CasuallyAlive/Fuschia_Navigator/Resources/CS5780 receipts.png

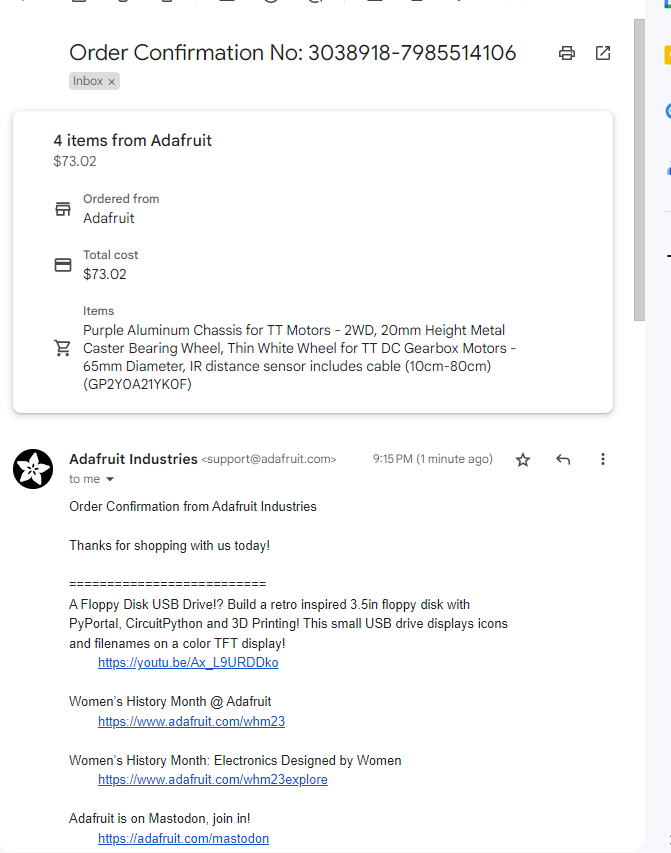
Resources/CS5780 receipts.png
