CasuallyAlive/Fuschia_Navigator/Resources/IMG_9270.jpg

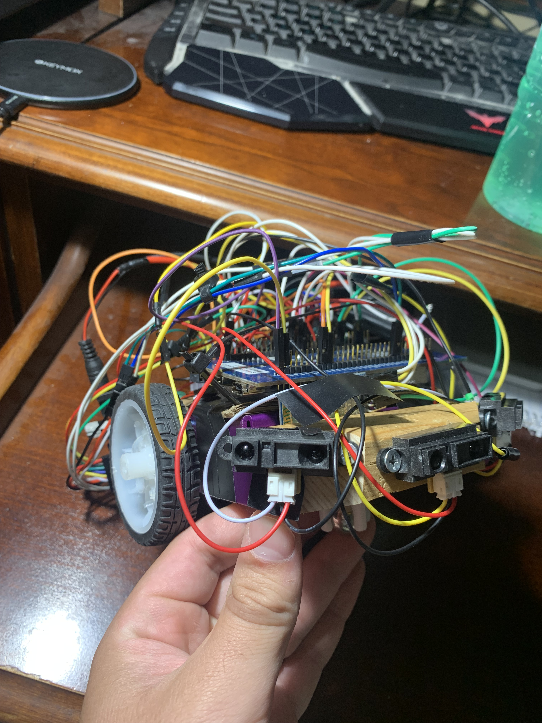
Resources/IMG_9270.jpg
