CasuallyAlive/Fuschia_Navigator/Resources/IMG_9274.jpg

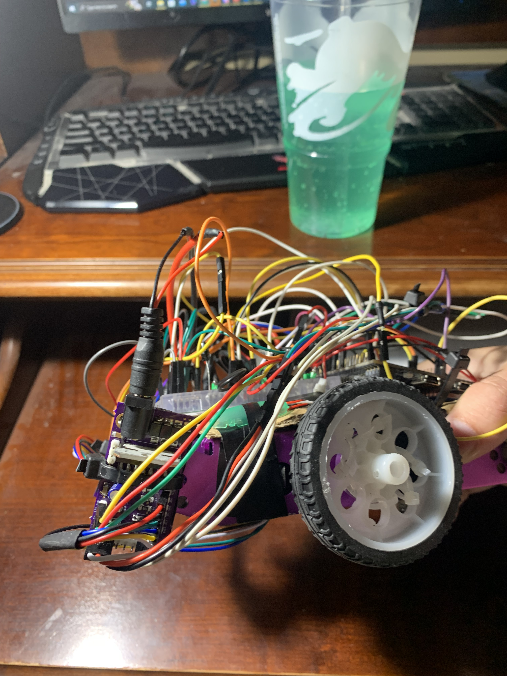
Resources/IMG_9274.jpg
