CasuallyAlive/Fuschia_Navigator/Resources/IMG_9275.jpg

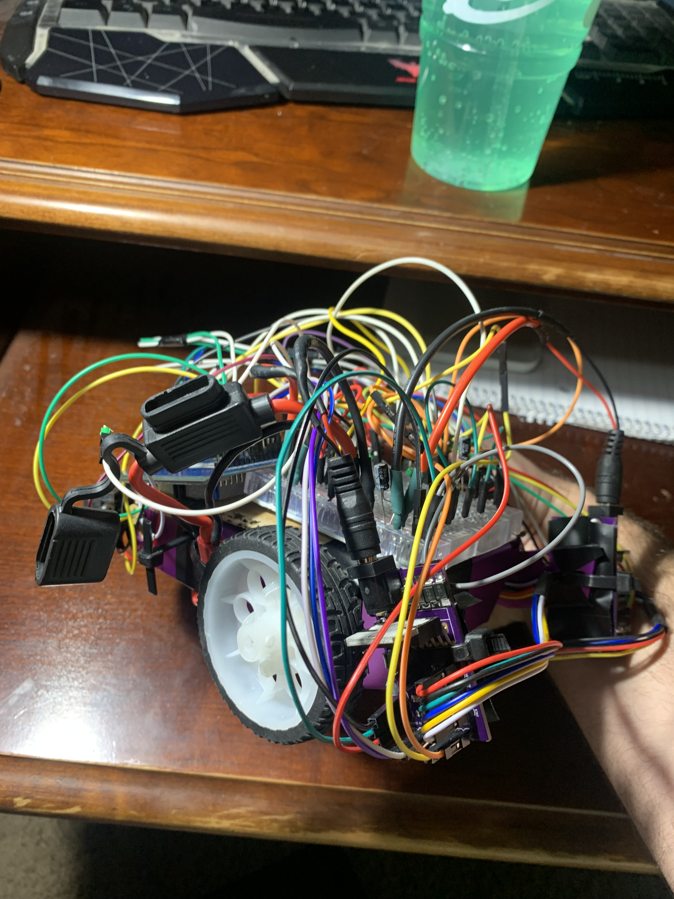
Resources/IMG_9275.jpg
