CasuallyAlive/Fuschia_Navigator/(commit log)

2023-04-19 Implemented functions for motor controller.
2023-04-19 Revert "Upload local to remote."
    This reverts commit b6c2ee202fd641cfea00d259e0e3ce57ce816e3d.
    [motor.c]
2023-04-19 Revert "Implemented functions for motor controller."
    This reverts commit de54166e3d81c70eddb05693efeb00b5d64d8338.
    [main.c, motor.c, motor.h]
2023-04-21 updated for single scan -- TODO: fix
    TODO: fix -- currently will only run the scan once and then freezes
2023-04-24 Implemented remaining timer setup functions.
    TODO: implement control in main to test and debug PID functions.
2023-05-02 Implemented PID control for wall following
    TODO-> update function pointer!
2023-05-03 Final Integration
    System not in a working state (compiles but doesn't function)!
    [IR.h, main.c, main.h, motor.c, motor.h, stmlibfuncs.c, stmlibfuncs.h]
