CasuallyAlive/Fuschia_Navigator/Resources/IMG_9271.jpg

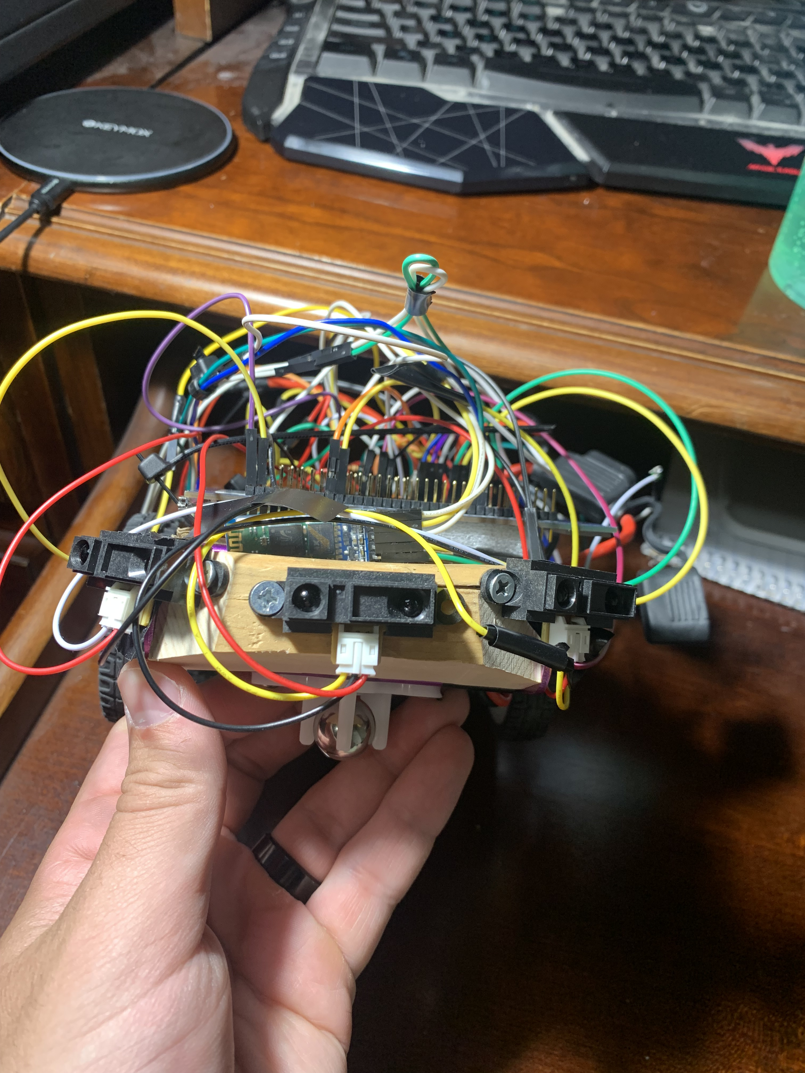
Resources/IMG_9271.jpg
