CasuallyAlive/Fuschia_Navigator/Resources/IMG_9272.jpg

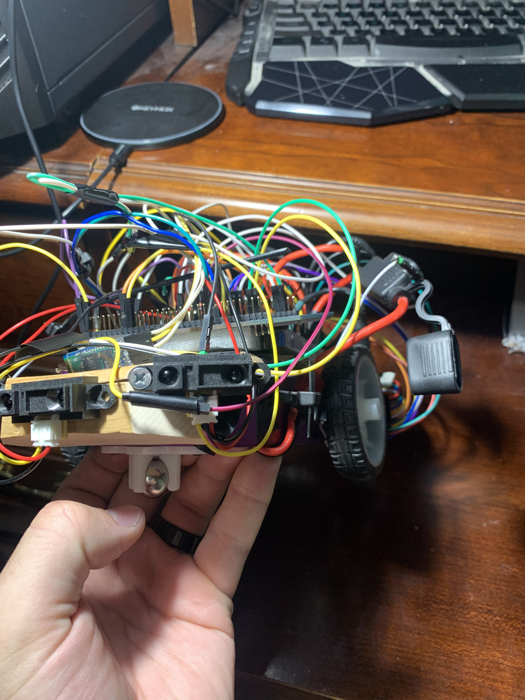
Resources/IMG_9272.jpg
