CasuallyAlive/Fuschia_Navigator/Resources/IMG_9273.jpg

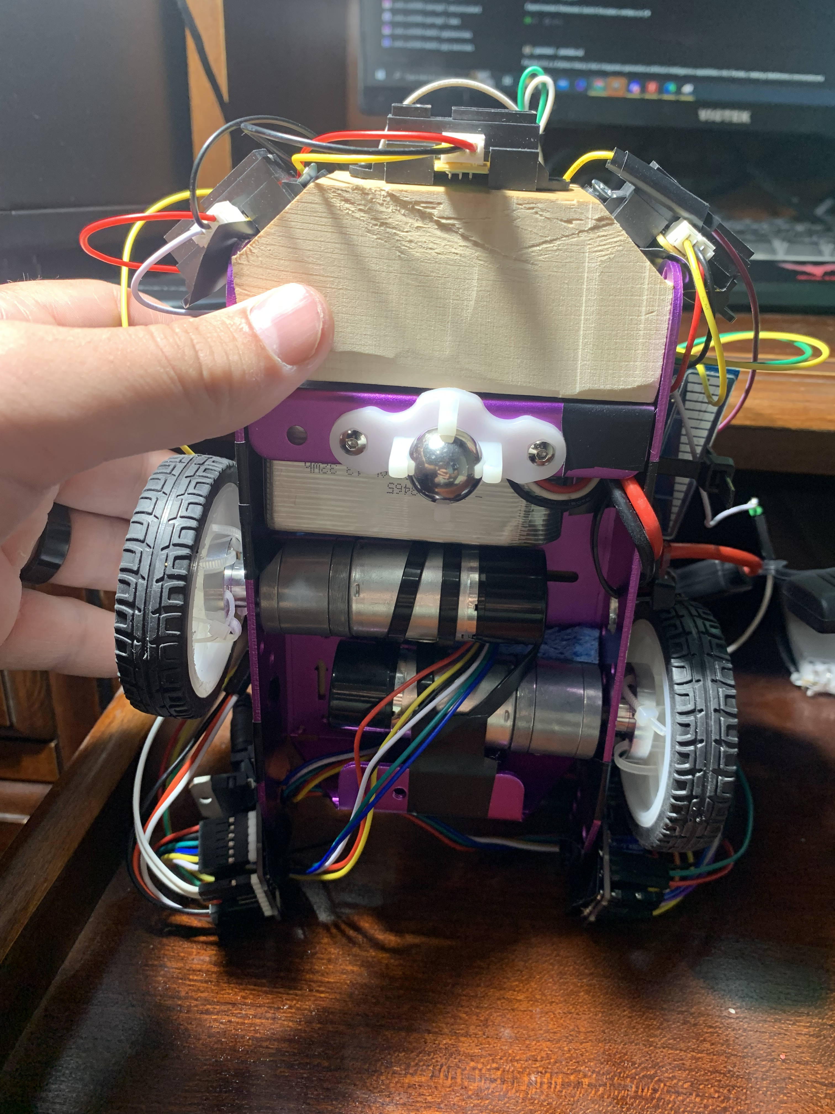
Resources/IMG_9273.jpg
