CasuallyAlive/Fuschia_Navigator/Resources/IMG_9276.jpg

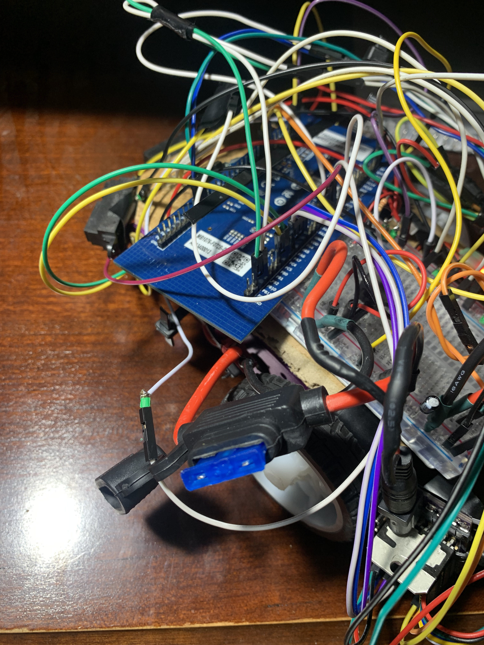
Resources/IMG_9276.jpg
