CasuallyAlive/Fuschia_Navigator/Resources/IMG_9277.jpg

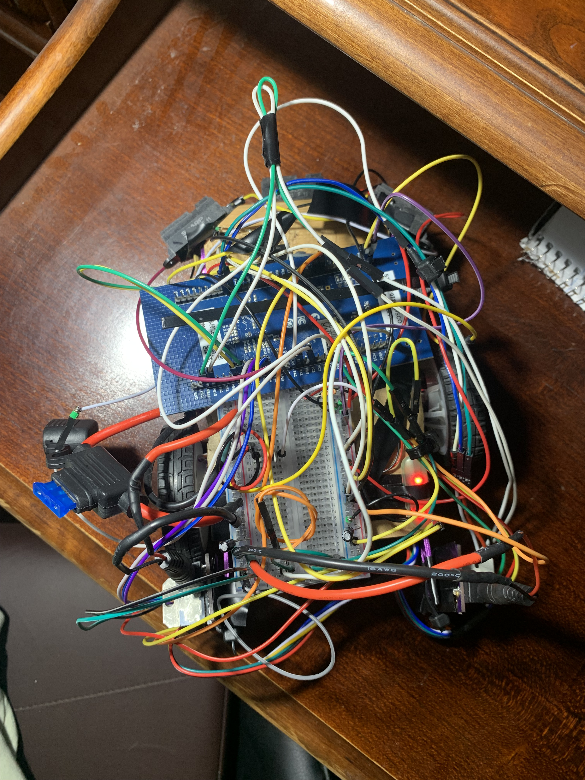
Resources/IMG_9277.jpg
